dangrie158/Class-D-Amplifier/Mechanical/Readme.md

# Mechanical / CAD Data

Fusion 360 Project is shared under: https://a360.co/2I7cZ26
