dangrie158/Class-D-Amplifier/Hardware/Amplifier+Mixer.pdf

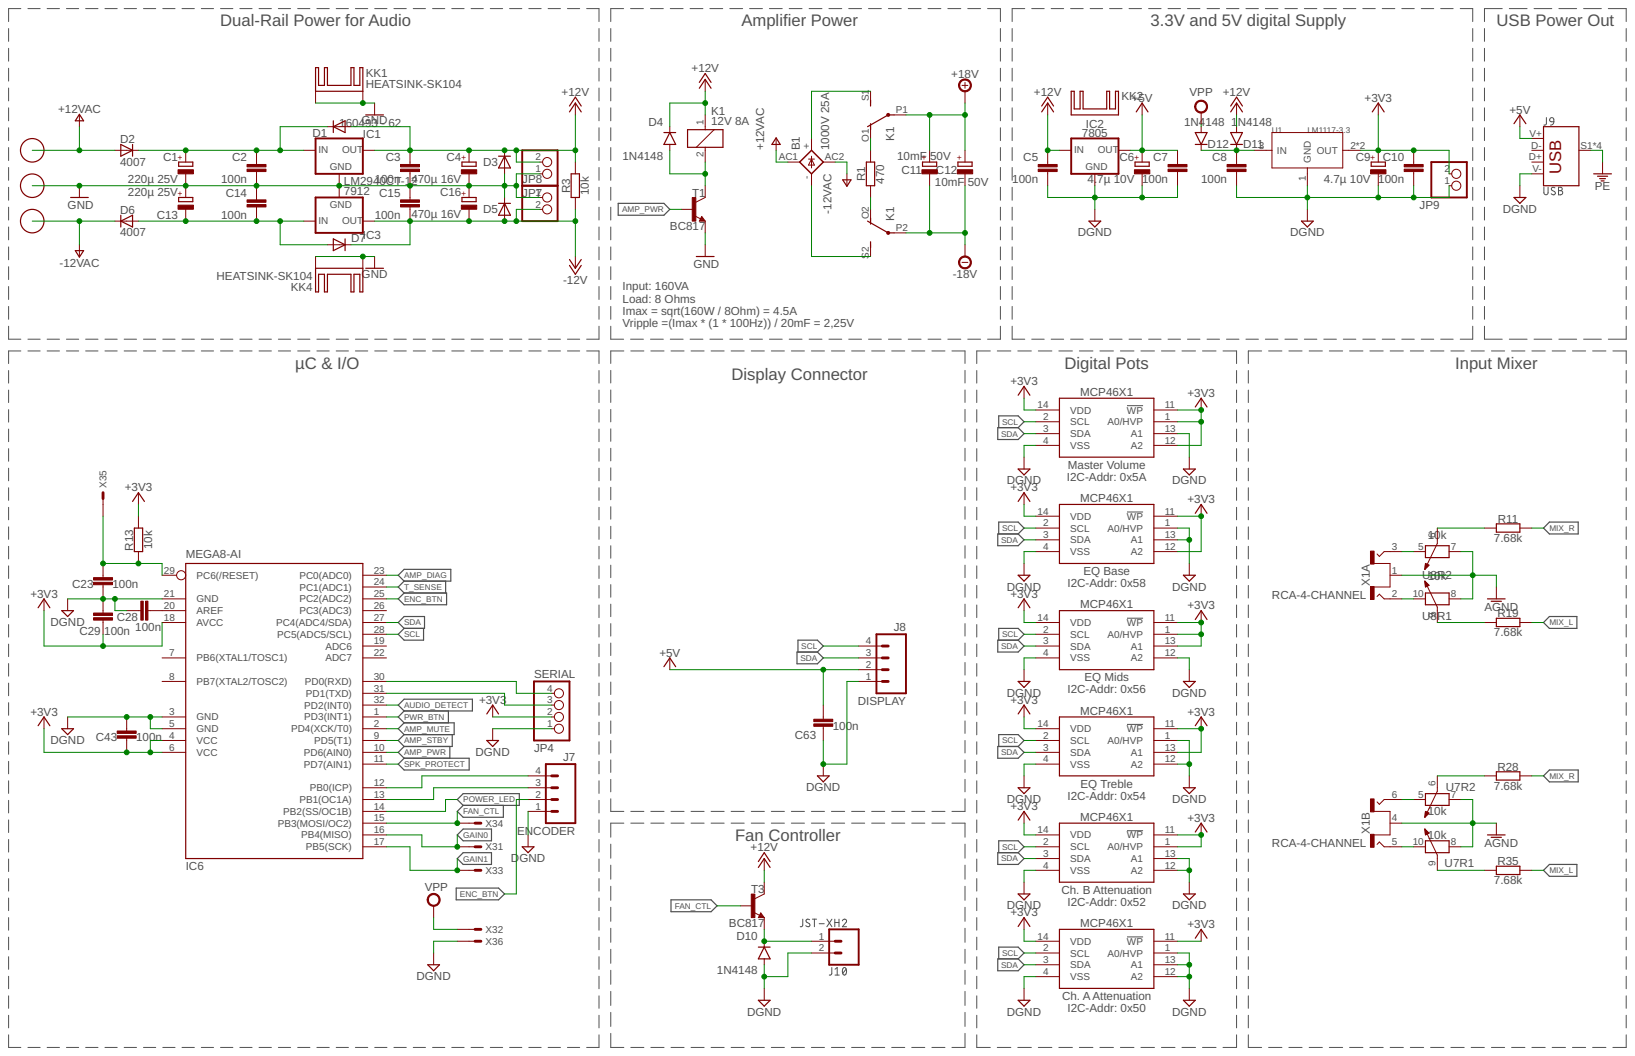
[picture p1: page 1]

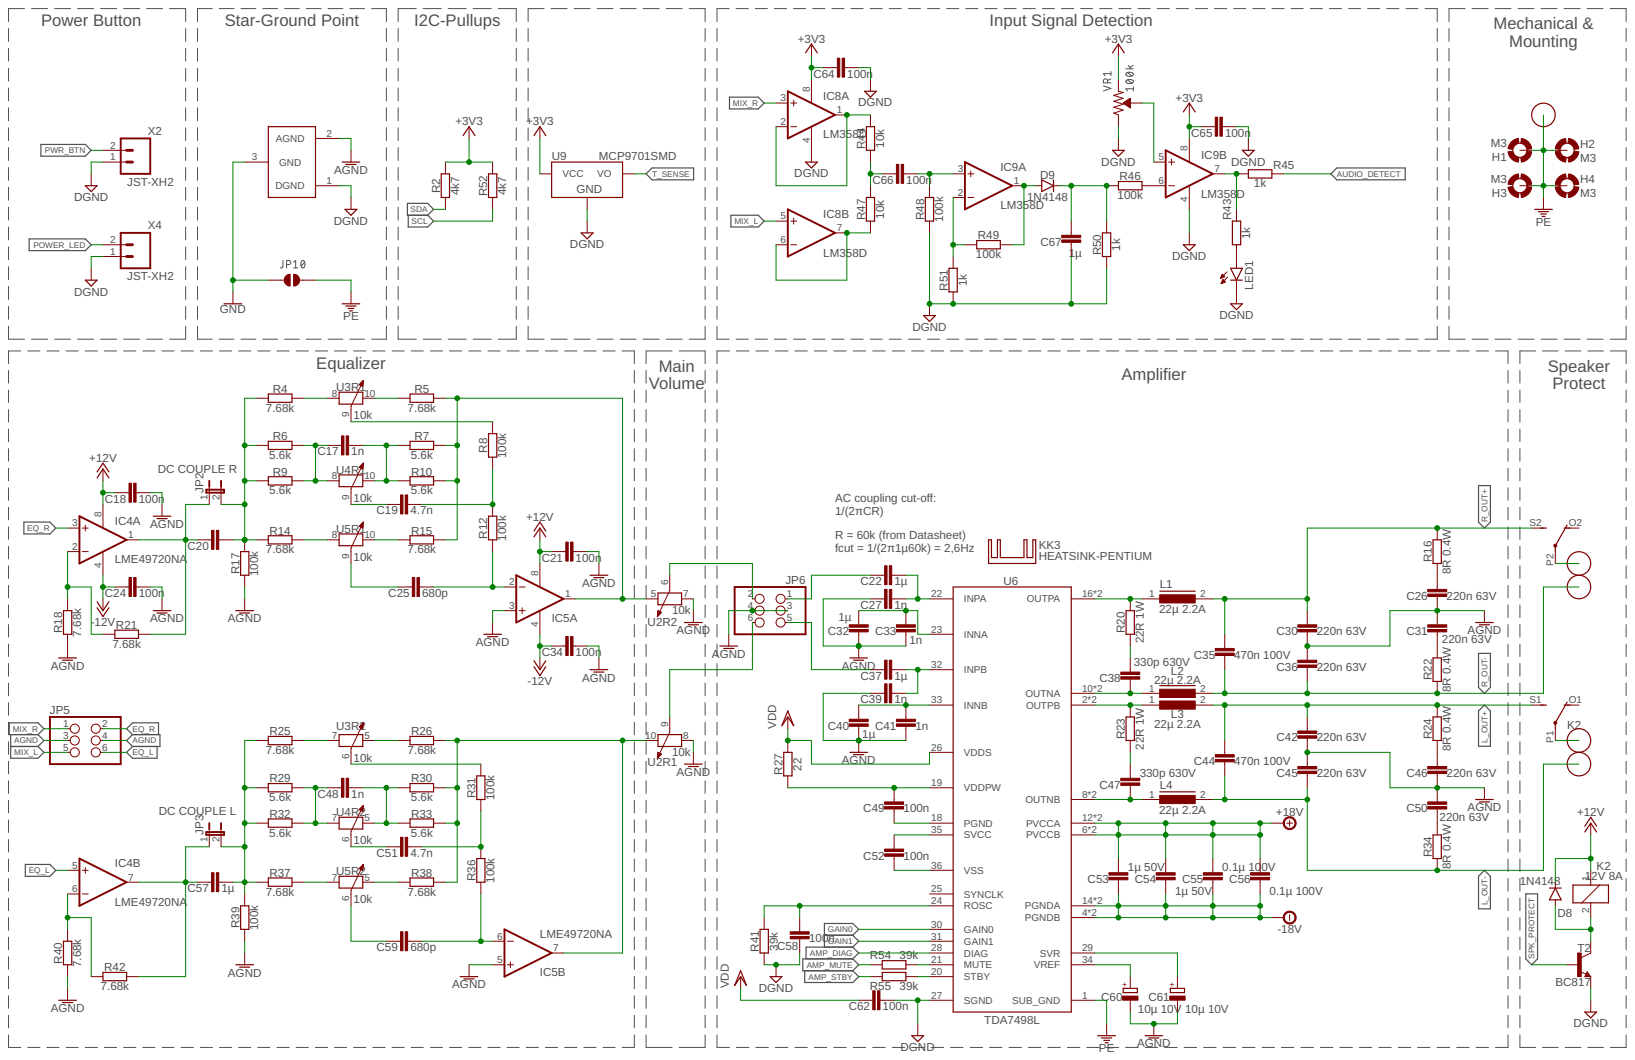
[picture p2: page 2]

AC coupling cut-off: 1/(2πCR) R = 60k (from Datasheet)
