dangrie158/Class-D-Amplifier/Hardware/Amplifier+Mixer.brd

## EAGLE design Hardware/Amplifier+Mixer.brd (2019-10-22)

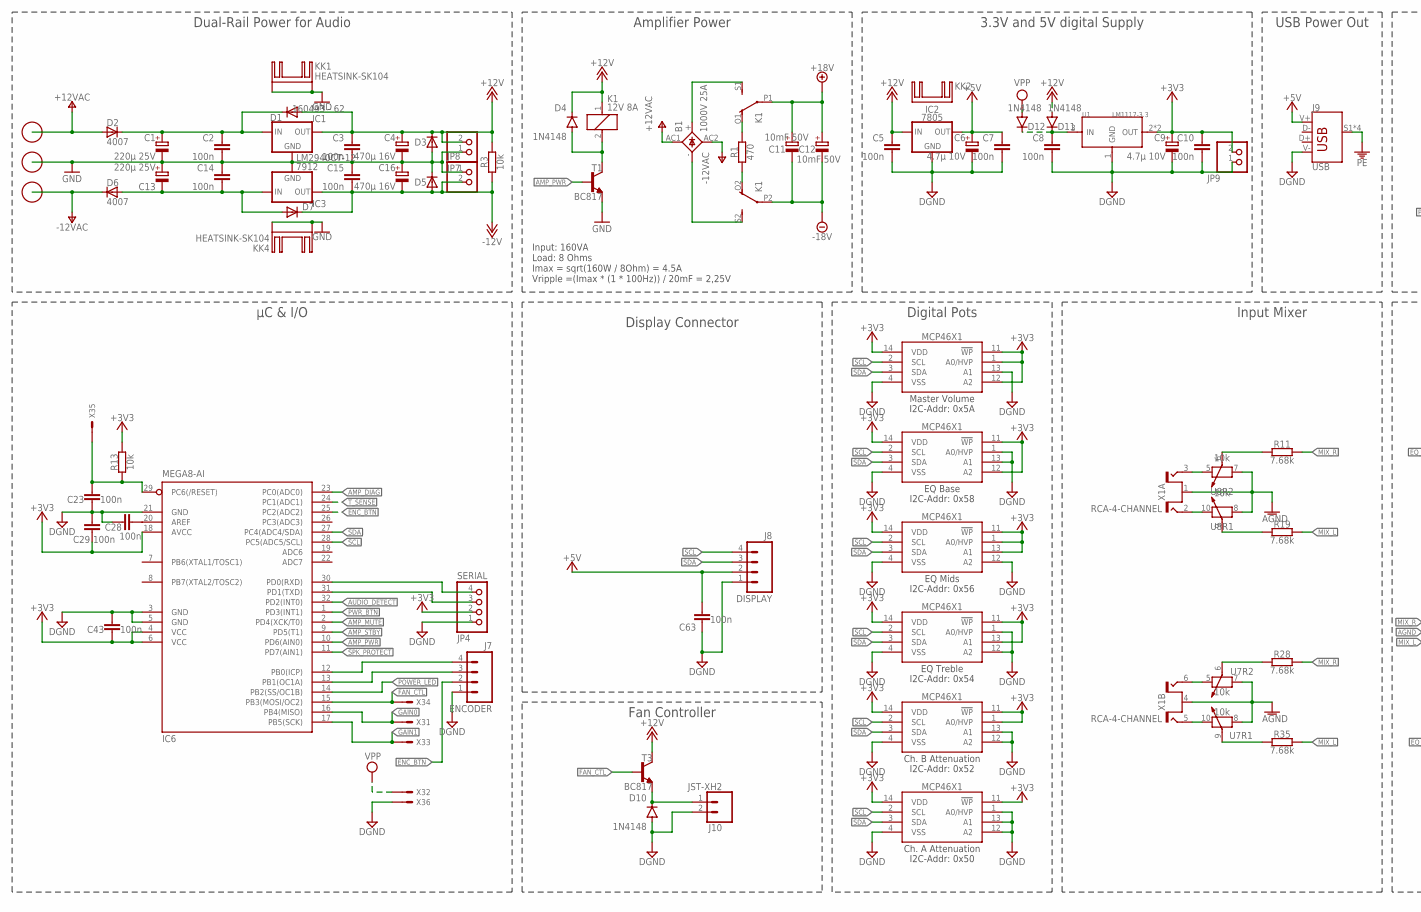
[picture p3: schematic Amplifier+Mixer.sch, part in row 1, column 1]

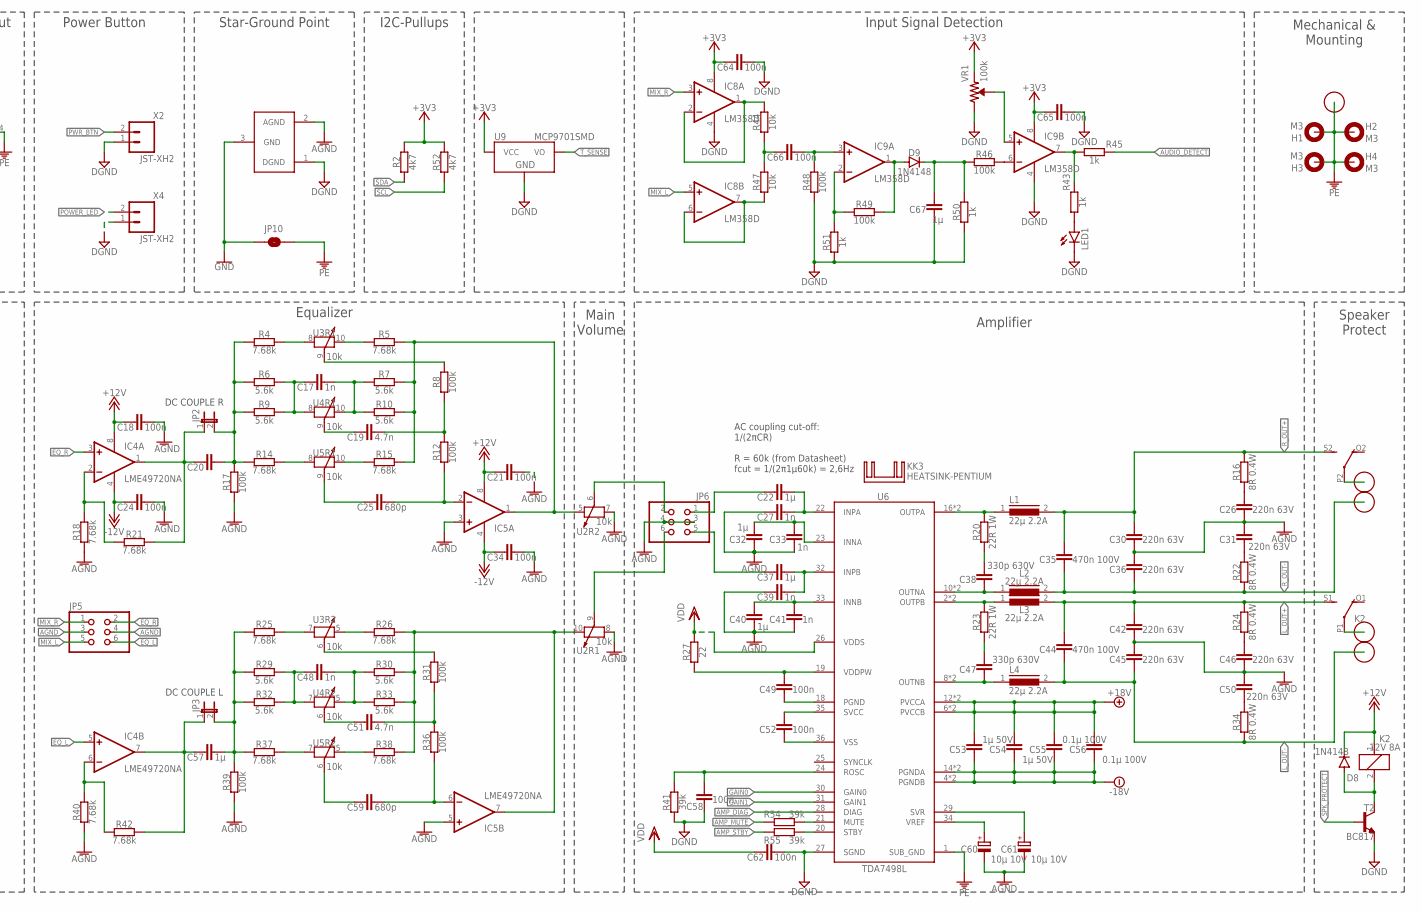
[picture p4: schematic Amplifier+Mixer.sch, part in row 1, column 2]

Parts:
B1: 1000V 25A; FB100; MOUSER 833-GBJL2510-BP
C1, C13: 220µ 25V; 175TMP-0810; MOUSER 647-UWT1E221MNL1GS
C2, C3, C5, C7, C8, C10, C14, C15, C18, C21, C23, C24, C28, C29, C34, C43, C49, C52, C58, C62, C63, C64, C65, C66: 100n; C0603; MOUSER 710-885012206071
C4, C16: 470µ 16V; 175TMP-0810; MOUSER 647-UWT1C471MNL1S
C6, C9: 4.7µ 10V; 153CLV-0505; MOUSER 710-865230642008
C11, C12: 10mF 50V; EB35D; MOUSER 647-LLS1H103MELC
C17, C27, C33, C39, C41, C48: 1n; C050-025X075; MOUSER 80-R82EC1100AA50K
C19, C51: 4.7n; C075-032X103; MOUSER 594-222237188472
C20: DC COUPLE L; C050-050X075; MOUSER 80-R82DC4100AA60K
C22, C32, C37, C40, C57: 1µ; C050-050X075; MOUSER 80-R82DC4100AA60K
C25, C59: 680p; C050-045X075; MOUSER 505-FKP2J006801D00KS
C26, C30, C31, C36, C42, C45, C46, C50: 220n 63V; C050-025X075; MOUSER 80-R82DC3220AA60K
C35, C44: 470n 100V; C050-045X075; MOUSER 505-MKS2D034701E00JI
C38, C47: 330p 630V; C050-045X075; MOUSER 505-FKP2C003301D00KI
C53, C54: 1µ 50V; C1206K; MOUSER 80-C1206C105M5RECLR
C55, C56: 0.1µ 100V; C1206K; MOUSER 77-VJ1206Y104KXBAT
C60, C61: 10µ 10V; 153CLV-0505; MOUSER 710-865080642006
C67: 1µ; C0603; MOUSER 710-885012106022
D1, D2, D3, D5, D6, D7: 4007; SODFL5024X231; MOUSER 583-FM4007W-W
D4, D8, D9, D10, D11, D12: 1N4148; SOD-323; MOUSER 512-1N4148WS
H1, H2, H3, H4: M3; 3,0-PAD
IC1: LM2940CT-12; 78XXS; MOUSER 511-L7812CV
IC2: 7805; 78XXS; MOUSER 511-L7805CV
IC3: 7912; 79XXS; MOUSER 511-L7912CV
IC4, IC5: LME49720NA; DIL08
IC6: MEGA8-AI; TQFP32-08; MOUSER 556-ATMEGA328-AU
IC8, IC9: LM358D; SO08; MOUSER 511-LM358DT
J1, J2, J3, J4: 6MM; TE-726386; MOUSER 571-726386-2
J5, J6: TERMINAL-BLOCK-2PLUG-IN; MSTBV2; MOUSER 651-1954919
J7: ENCODER; JST-4-PTH-VERT; MOUSER 538-35312-0260
J8: DISPLAY; JST-4-PTH-VERT; MOUSER 538-35312-0260
J9: USB; ECON-USBBUVA; MOUSER 523-GSB19110KEU
J10: JST-XH2; JST-2-PTH-VERT; MOUSER 575-3191010200006000
JP1: GND_CONNECT
JP2: DC COULE R; JP1; MOUSER 200-TSW10223TS
JP3: DC COUPLE L; JP1; MOUSER 200-TSW10223TS
JP4: SERIAL; 1X04; MOUSER 649-68001-204HLF
JP5: MIX OUT; 2X03
JP6: PREAMP OUT; 2X03
JP7, JP8, JP9: PINHD-1X2; 1X02
JP10: PEGND; SMT-JUMPER_2_NO_NO-SILK
K1, K2: 12V 8A; F4052; MOUSER 655-RT424012
KK1, KK4: HEATSINK-SK104; SK104-PAD; MOUSER 490-HSE-B20254-035H
KK2: HEATSINK-SK95; SK95-2M3; MOUSER 490-HSE-B2111-038
KK3: HEATSINK-PENTIUM
L1, L2, L3, L4: 22µ 2.2A; INDUCTOR-12MM; MOUSER 710-744771220
LED1: LEDCHIP-LED0603; CHIP-LED0603
R1: 470; 0617/22; MOUSER 279-EP5WS470RJ
R2, R52: 4k7; R0603; MOUSER 603-AC0603JR-134K7L
R3, R13, R44, R47: 10k; R0603; MOUSER 603-RC0603FR-0710KL
R4, R5, R11, R14, R15, R18, R19, R21, R25, R26, R28, R35, R37, R38, R40, R42: 7.68k; MINI_MELF-0207W; MOUSER 71-SMM02070C7501FBP0
R6, R7, R9, R10, R29, R30, R32, R33: 5.6k; MINI_MELF-0207W; MOUSER 71-SMM02070C5601FBP0
R8, R12, R17, R31, R36, R39: 100k; MINI_MELF-0204W; MOUSER 756-WRM024HPC100KFT3
R16, R22, R24, R34: 8R 0.4W; MINI_MELF-0204W; MOUSER 756-WRM0204HPC8R2FT3
R20, R23: 22R 1W; MINI_MELF-0207W; MOUSER 756-WRM0207HPC22RFT2
R27: 22; R0603; MOUSER 603-RC0603FR-0722RL
R41: 39k; R0603; MOUSER 603-RC0603FR-0739KL
R43, R45, R50, R51: 1k; R0603; MOUSER 603-RC0603FR-071KL
R46, R48, R49: 100k; R0603; MOUSER 71-RCA0603100KJNEC
R54, R55: 39k; R0603; MOUSER 71-RCA0603100KJNEC
T1, T2, T3: BC817; SOT23-BEC; MOUSER 863-BC817-16LT3G
U1: LM1117-3.3; SOT-223; MOUSER 926-LM1117MPX3.3NOPB
U2, U3, U4, U5, U7, U8: 10k; SOP65P640X120-14; MOUSER 579-MCP4641-103E/ST
U6: TDA7498L; SOP50P1010X245-36; MOUSER 511-TDA7498TR
U9: MCP9701SMD; SOT23-3
VR1: 100k; TRIMPOT-SMD-TC33X; MOUSER 858-35WR100KLFTR
X1: RCA-4-CHANNEL; BKL-072385; MOUSER 806-KLP42X-61-WWRR
X2, X4: JST-XH2; JST-2-PTH-VERT; MOUSER 575-3191010200006000
X3: ICSP; 057-006-1; MOUSER 200-TSW10307TD

Connections:
+3V3: C9.+, C10.1, C29.1, C43.1, C64.1, C65.1, IC6.4 (VCC), IC6.6 (VCC), IC6.18 (AVCC), IC8.8 (V+), IC9.8 (V+), JP4.2, JP9.2, R2.2, R13.2, R52.2, U1.2 (OUT), U1.TER (OUT), U2.1 (A0/HVP), U2.11 (!WP), U2.12 (A2), U2.14 (VDD), U3.11 (!WP), U3.12 (A2), U3.14 (VDD), U4.1 (A0/HVP), U4.11 (!WP), U4.13 (A1), U4.14 (VDD), U5.11 (!WP), U5.13 (A1), U5.14 (VDD), U7.1 (A0/HVP), U7.11 (!WP), U7.14 (VDD), U8.11 (!WP), U8.14 (VDD), U9.1 (VCC), VR1.3 (CCW)
+5V: C6.+, C7.1, C63.2, IC2.OUT, J8.2, J9.V+ (VBUS)
+12V: C3.1, C4.+, C5.1, C18.1, C21.1, D1.A, D3.C, D4.C, D8.C, D11.A, IC1.OUT, IC2.IN, IC4.8 (V+), IC5.8 (V+), JP7.2, K1.1, K2.1, R3.1, T3.C
+18V: C11.+, C12.+, C53.1, C54.1, C55.1, C56.1, K1.P1, U6.6 (PVCCB), U6.7 (PVCCB), U6.12 (PVCCA), U6.13 (PVCCA)
-12V: C15.2, C16.-, C24.1, C34.1, D5.A, D7.C, IC3.OUT, IC4.4 (V-), IC5.4 (V-), JP8.2, R3.2
-18V: C11.-, C12.-, C53.2, C54.2, C55.2, C56.2, K1.P2, U6.4 (PGNDB), U6.5 (PGNDB), U6.14 (PGNDA), U6.15 (PGNDA)
AGND: C18.2, C21.2, C24.2, C26.2, C27.1, C30.2, C31.1, C32.1, C33.1, C34.2, C36.1, C39.1, C40.1, C41.1, C42.2, C45.1, C46.2, C50.1, C60.-, C61.-, IC5.3 (+IN), IC5.5 (+IN), JP1.2 (AGND), JP5.3, JP5.4, JP6.3, JP6.4, R17.1, R18.2, R39.1, R40.2, U2.7 (A), U2.8 (A), U7.7 (A), U7.8 (A), U8.7 (A), U8.8 (A), X1.1 (S), X1.4 (S)
AMP_DIAG: IC6.23 (PC0(ADC0)), U6.28 (DIAG)
AMP_MUTE: IC6.2 (PD4(XCK/T0)), R54.2
AMP_MUTE_CL: R54.1, U6.21 (MUTE)
AMP_PWR: IC6.10 (PD6(AIN0)), T1.B
AMP_STBY: IC6.9 (PD5(T1)), R55.2
AMP_STBY_CL: R55.1, U6.20 (STBY)
AUDIO_DETECT: IC6.32 (PD2(INT0)), R45.1
DGND: C5.2, C6.-, C7.2, C8.2, C9.-, C10.2, C23.1, C28.2, C29.2, C43.2, C58.2, C62.1, C63.1, C64.2, C65.2, C67.1, D10.A, IC2.GND, IC6.3 (GND), IC6.5 (GND), IC6.21 (GND), IC8.4 (V-), IC9.4 (V-), J7.1, J8.1, J9.V- (GND), J10.2, JP1.1 (DGND), JP4.1, JP9.1, LED1.C, R41.1, R48.1, R50.1, R51.1, T2.E, U1.1 (GND), U2.4 (VSS), U2.13 (A1), U3.1 (A0/HVP), U3.4 (VSS), U3.13 (A1), U4.4 (VSS), U4.12 (A2), U5.1 (A0/HVP), U5.4 (VSS), U5.12 (A2), U6.27 (SGND), U7.4 (VSS), U7.12 (A2), U7.13 (A1), U8.1 (A0/HVP), U8.4 (VSS), U8.12 (A2), U8.13 (A1), U9.3 (GND), VR1.1 (CW), X2.1, X3.6, X4.1
ENC_BTN: IC6.25 (PC2(ADC2)), J7.2
EQ_L: IC4.5 (+IN), JP5.6
EQ_OUT_L: IC5.7 (OUT), R26.1, R30.1, R33.1, R38.1, U2.10 (B)
EQ_OUT_R: IC5.1 (OUT), R5.1, R7.1, R10.1, R15.1, U2.5 (B)
EQ_R: IC4.3 (+IN), JP5.2
FAN_CTL: IC6.15 (PB3(MOSI/OC2)), T3.B, X3.4
GAIN0: IC6.16 (PB4(MISO)), U6.30 (GAIN0), X3.1
GAIN1: IC6.17 (PB5(SCK)), U6.31 (GAIN1), X3.3
GND: C1.-, C2.2, C3.2, C4.-, C13.+, C14.1, C15.1, C16.+, D3.A, D5.C, IC1.GND, IC3.GND, J2.P$1, J2.P$2, JP1.3 (GND), JP7.1, JP8.1, JP10.1, KK1.K1, KK1.K2, KK4.K1, KK4.K2, T1.E
INNA: C32.2, C33.2, U6.23 (INNA)
INNB: C40.2, C41.2, U6.33 (INNB)
INPA: C22.2, C27.2, U6.22 (INPA)
INPB: C37.2, C39.2, U6.32 (INPB)
L_OUT+: C42.1, C44.1, K2.S1 (S), L3.2, R24.2
L_OUT-: C44.2, C45.2, J6.1, L4.2, R34.1
MIX_AMP_L: C57.1, IC4.7 (OUT), JP3.1, R42.1
MIX_AMP_R: C20.1, IC4.1 (OUT), JP2.1, R21.1
MIX_L: IC8.5 (+IN), JP5.5, R19.2, R35.2
MIX_R: IC8.3 (+IN), JP5.1, R11.2, R28.2
unnamed: C20.2, JP2.2, R4.2, R6.2, R9.2, R14.2, R17.2
unnamed: R14.1, U5.8 (A)
unnamed: C25.2, U5.9 (W)
unnamed: R15.2, U5.10 (B)
unnamed: C17.1, R6.1, R9.1, U4.8 (A)
unnamed: C57.2, JP3.2, R25.2, R29.2, R32.2, R37.2, R39.2
unnamed: R8.2, U3.9 (W)
unnamed: R31.2, U3.6 (W)
unnamed: B1.+, K1.S1 (S)
unnamed: R26.2, U3.5 (B)
unnamed: C19.2, U4.9 (W)
unnamed: C19.1, R8.1, R12.2
unnamed: C66.1, R44.1, R47.2
unnamed: R25.1, U3.7 (A)
unnamed: C17.2, R7.2, R10.2, U4.10 (B)
unnamed: C59.2, U5.6 (W)
unnamed: C51.2, U4.6 (W)
unnamed: R4.1, U3.8 (A)
unnamed: C48.1, R29.1, R32.1, U4.7 (A)
unnamed: C48.2, R30.2, R33.2, U4.5 (B)
unnamed: R37.1, U5.7 (A)
unnamed: R38.2, U5.5 (B)
unnamed: C13.-, C14.2, D6.A, D7.A, IC3.IN
unnamed: C1.+, C2.1, D1.C, D2.C, IC1.IN
unnamed: C66.2, IC9.3 (+IN), R48.2
unnamed: C52.2, U6.36 (VSS)
unnamed: B1.-, K1.S2 (S)
unnamed: R5.2, U3.10 (B)
unnamed: C51.1, R31.1, R36.2
unnamed: C52.1, U6.35 (SVCC)
unnamed: IC9.2 (-IN), R49.2, R51.2
unnamed: D9.A, IC9.1 (OUT), R49.1
unnamed: C67.2, D9.C, R46.2, R50.2
unnamed: IC9.6 (-IN), R46.1
unnamed: IC9.5 (+IN), VR1.2 (WIPER)
unnamed: IC9.7 (OUT), R43.1, R45.2
unnamed: LED1.A, R43.2
unnamed: IC8.6 (-IN), IC8.7 (OUT), R47.1
unnamed: IC8.1 (OUT), IC8.2 (-IN), R44.2
unnamed: U7.5 (B), X1.6 (T2)
unnamed: U7.10 (B), X1.5 (T1)
unnamed: R35.1, U7.9 (W)
unnamed: R28.1, U7.6 (W)
unnamed: IC4.6 (-IN), R40.1, R42.2
unnamed: IC4.2 (-IN), R18.1, R21.2
unnamed: U8.5 (B), X1.3 (T2)
unnamed: U8.10 (B), X1.2 (T1)
unnamed: R19.1, U8.9 (W)
unnamed: R11.1, U8.6 (W)
unnamed: D4.A, K1.2, T1.C
unnamed: J6.2, K2.P1
unnamed: K1.O1 (O), R1.1
unnamed: C58.1, R41.2, U6.24 (ROSC)
unnamed: C49.1, R27.1, U6.19 (VDDPW)
unnamed: C49.2, U6.18 (PGND)
unnamed: C8.1, D11.C, D12.C, U1.3 (IN)
unnamed: K1.O2 (O), R1.2
unnamed: J5.1, K2.P2
unnamed: C50.2, R34.2
unnamed: D10.C, J10.1, T3.E
unnamed: C46.1, R24.1
unnamed: C60.+, U6.34 (VREF)
unnamed: C61.+, U6.29 (SVR)
unnamed: C31.2, R22.2
unnamed: C26.1, R16.1
unnamed: C47.2, L4.1, U6.8 (OUTNB), U6.9 (OUTNB)
unnamed: C38.2, L2.1, U6.10 (OUTNA), U6.11 (OUTNA)
unnamed: C38.1, R20.1
unnamed: C47.1, R23.1
unnamed: L1.1, R20.2, U6.16 (OUTPA), U6.17 (OUTPA)
unnamed: L3.1, R23.2, U6.2 (OUTPB), U6.3 (OUTPB)
unnamed: D8.A, K2.2, T2.C
unnamed: IC6.13 (PB1(OC1A)), J7.3
unnamed: C28.1, IC6.20 (AREF)
unnamed: IC6.12 (PB0(ICP)), J7.4
unnamed: C22.1, JP6.1
unnamed: C23.2, IC6.29 (PC6(/RESET)), R13.1, X3.5
unnamed: C37.1, JP6.5
unnamed: IC6.30 (PD0(RXD)), JP4.4
unnamed: IC6.31 (PD1(TXD)), JP4.3
OUT_L_DAMPED: C59.1, IC5.6 (-IN), R36.1
OUT_R_DAMPED: C25.1, IC5.2 (-IN), R12.1
PE: H1.B3,0, H2.B3,0, H3.B3,0, H4.B3,0, J4.P$1, J4.P$2, J9.S1 (SHIELD), J9.S2 (SHIELD), J9.S3 (SHIELD), J9.S4 (SHIELD), JP10.2, U6.1 (SUB_GND)
POWER_LED: IC6.14 (PB2(SS/OC1B)), X4.2
PREAMP_OUT_L: JP6.6, U2.9 (W)
PREAMP_OUT_R: JP6.2, U2.6 (W)
PWR_BTN: IC6.1 (PD3(INT1)), X2.2
R_OUT+: C30.1, C35.1, K2.S2 (S), L1.2, R16.2
R_OUT-: C35.2, C36.2, J5.2, L2.2, R22.1
SCL: IC6.28 (PC5(ADC5/SCL)), J8.4, R52.1, U2.2 (SCL), U3.2 (SCL), U4.2 (SCL), U5.2 (SCL), U7.2 (SCL), U8.2 (SCL)
SDA: IC6.27 (PC4(ADC4/SDA)), J8.3, R2.1, U2.3 (SDA), U3.3 (SDA), U4.3 (SDA), U5.3 (SDA), U7.3 (SDA), U8.3 (SDA)
SPK_PROTECT: IC6.11 (PD7(AIN1)), T2.B
T_SENSE: IC6.24 (PC1(ADC1)), U9.2 (VO)
V+: B1.AC1, D2.A, J1.P$1, J1.P$2
V-: B1.AC2, D6.C, J3.P$1, J3.P$2
VDD: C62.2, R27.2, U6.26 (VDDS)
VPP: D12.A, X3.2

Notes on the sheet:
I2C-Addr: 0x50
I2C-Addr: 0x52
I2C-Addr: 0x54
I2C-Addr: 0x56
I2C-Addr: 0x58
I2C-Addr: 0x5A
Ch. A Attenuation
Ch. B Attenuation
EQ Treble
EQ Mids
EQ Base
Master Volume
Amplifier
Speaker Protect
Main Volume
Equalizer
Input Mixer
Digital Pots
Display Connector
Fan Controller
µC & I/O
Input Signal Detection
Amplifier Power
Dual-Rail Power for Audio
3.3V and 5V digital Supply
USB Power Out
Power Button
Star-Ground Point
Mechanical & Mounting
I2C-Pullups
DC COUPLE L
DC COUPLE R
Input: 160VA Load: 8 Ohms Imax = sqrt(160W / 8Ohm) = 4.5A Vripple =(Imax * (1 * 100Hz)) / 20mF = 2,25V
AC coupling cut-off: 1/(2πCR) R = 60k (from Datasheet) fcut = 1/(2π1µ60k) = 2,6Hz

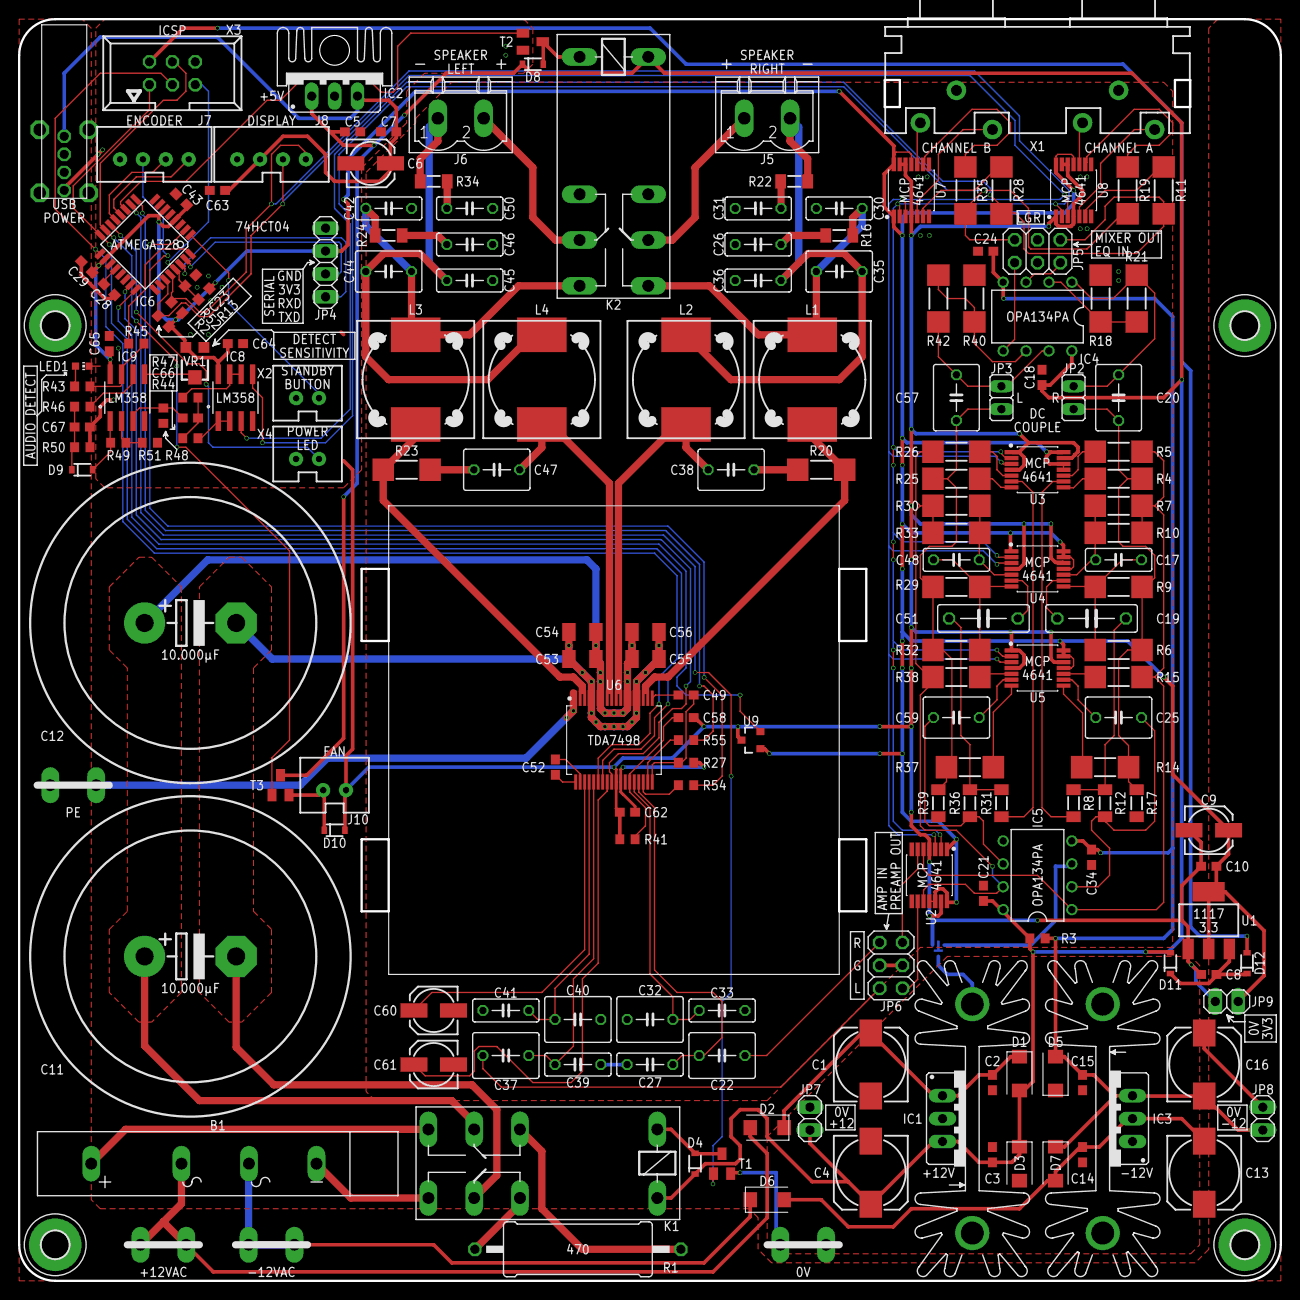
[picture p5: board Amplifier+Mixer.brd from above]

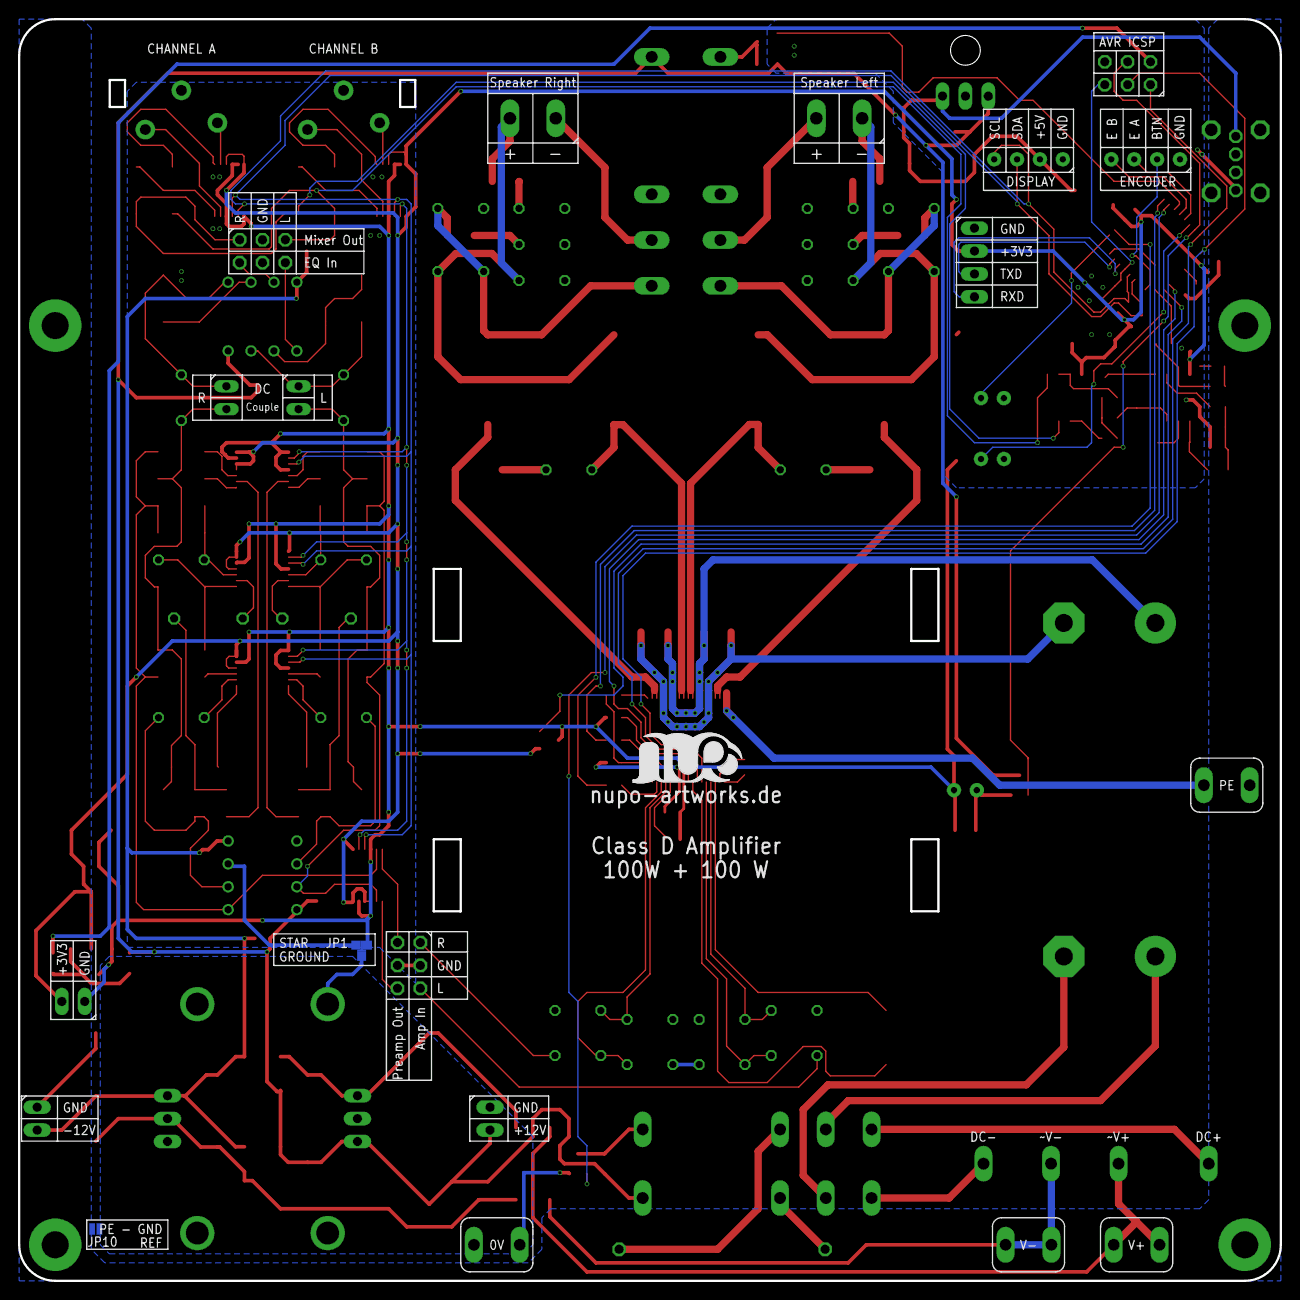
[picture p6: board Amplifier+Mixer.brd from below]

Board: 2 copper layers, 140.0 x 140.0 mm, 195 parts (3 on the bottom side), 131 nets.

Other parts of the board:
U$1: LOGO-SILKSCREEN
