dangrie158/Class-D-Amplifier/(commit log)

2019-02-11 Modularized schematic and cleaned up component designators
    [Amplifier+Mixer.sch]
2019-02-11 consolidated some components to minimize BOM
    [Amplifier+Mixer.brd, Amplifier+Mixer.sch]
2019-02-13 added BOM and tooling to backannotate BOM to attributes
    [Amplifier+Mixer.csv, Amplifier+Mixer.xlsx]
2019-02-13 added order numbers for conrad and mouser as attributes of the parts
    [Amplifier+Mixer.brd, Amplifier+Mixer.sch]
2019-02-17 first routing pass
    [Amplifier+Mixer.brd, Amplifier+Mixer.sch]
2019-02-18 first silkscreen placement pass
    [Amplifier+Mixer.brd, Amplifier+Mixer.sch]
2019-02-18 added temp sensor for amp chip heatsink
    [Amplifier+Mixer.brd, Amplifier+Mixer.sch]
2019-02-18 improved temp sensor routing
    [Amplifier+Mixer.brd]
2019-02-18 added power led connector
    [Amplifier+Mixer.brd, Amplifier+Mixer.sch]
2019-02-20 removed 74hct04 for level shifting
    [Amplifier+Mixer.brd, Amplifier+Mixer.sch]
2019-02-21 removed gain selection dip switch and wired gain pins to µC
    [Amplifier+Mixer.brd, Amplifier+Mixer.sch]
2019-02-22 added indicator LED to audio detection circuit
    [Amplifier+Mixer.brd, Amplifier+Mixer.sch]
2019-02-22 moved power led to pwm capable pin
    [Amplifier+Mixer.brd, Amplifier+Mixer.sch]
2019-02-23 added flowchart for firmare logic
2019-02-23 added fan speed control dependent on heatsink temperature
2019-03-17 fixed i2c communication with epots
    [main.cpp]
2019-03-17 fixed feedback network in mixer buffer output stage
    [Amplifier+Mixer.brd, Amplifier+Mixer.sch]
2019-10-22 updated to newest version
    [Amplifier+Mixer.brd, Amplifier+Mixer.sch]
